aimeemcvey/spirometer/Images/TopView.png

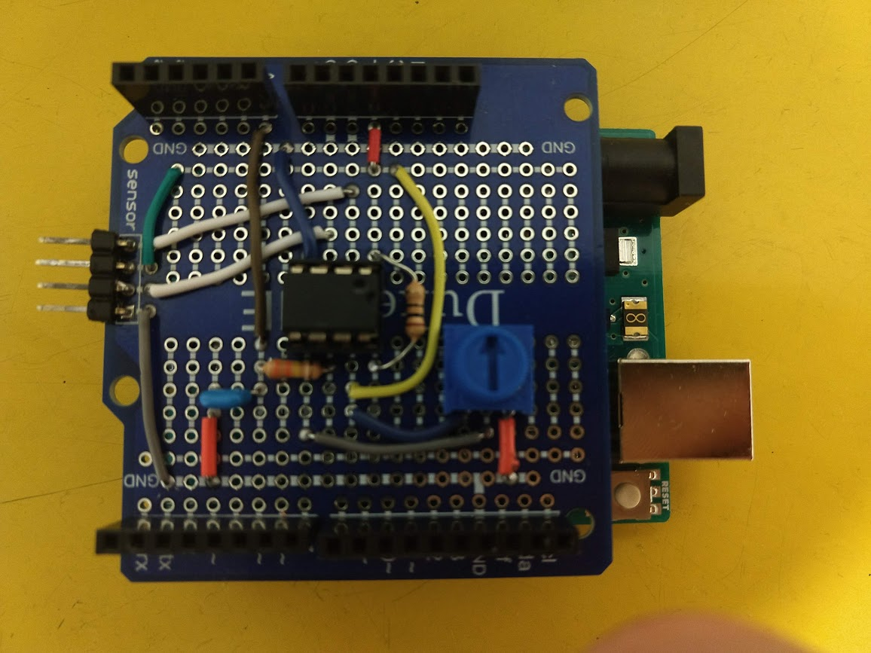
Images/TopView.png
